threeye11/STM32F4-TouchWeather-OTA-Clock/picture/7.jpg

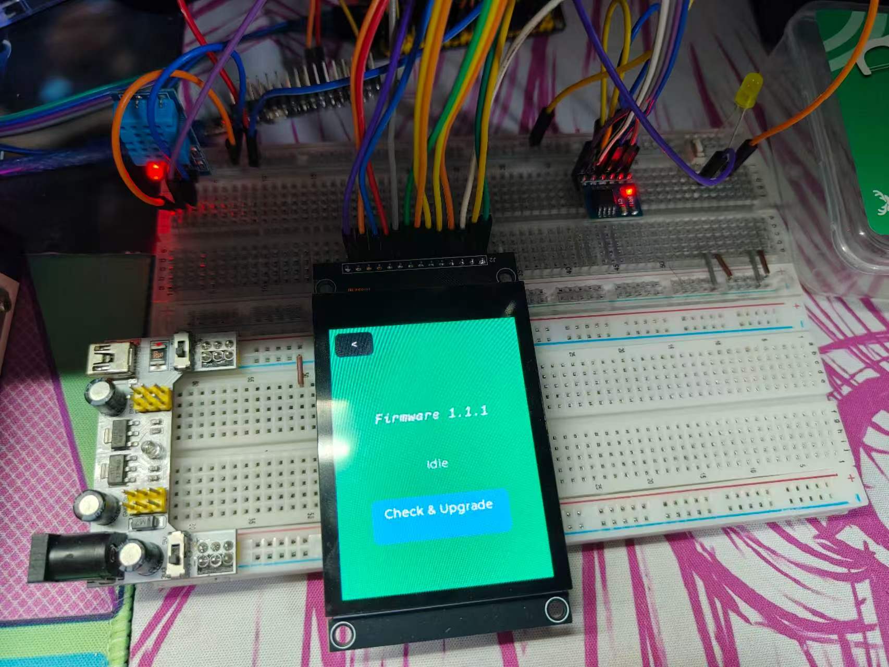
picture/7.jpg
