threeye11/STM32F4-TouchWeather-OTA-Clock/picture/4.jpg

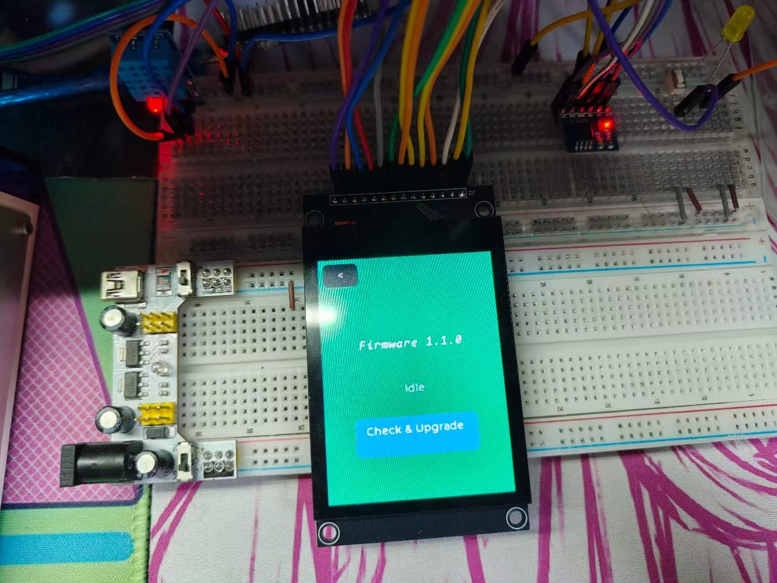
picture/4.jpg
