threeye11/STM32F4-TouchWeather-OTA-Clock/picture/1.jpg

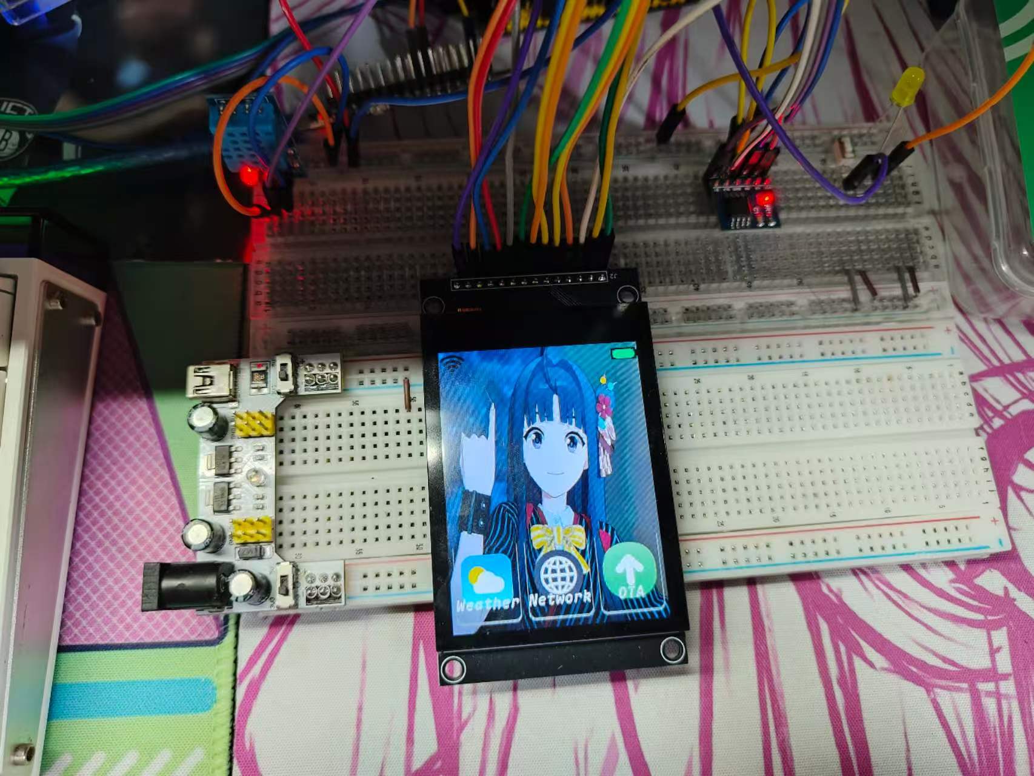
picture/1.jpg
