threeye11/STM32F4-TouchWeather-OTA-Clock/picture/2.jpg

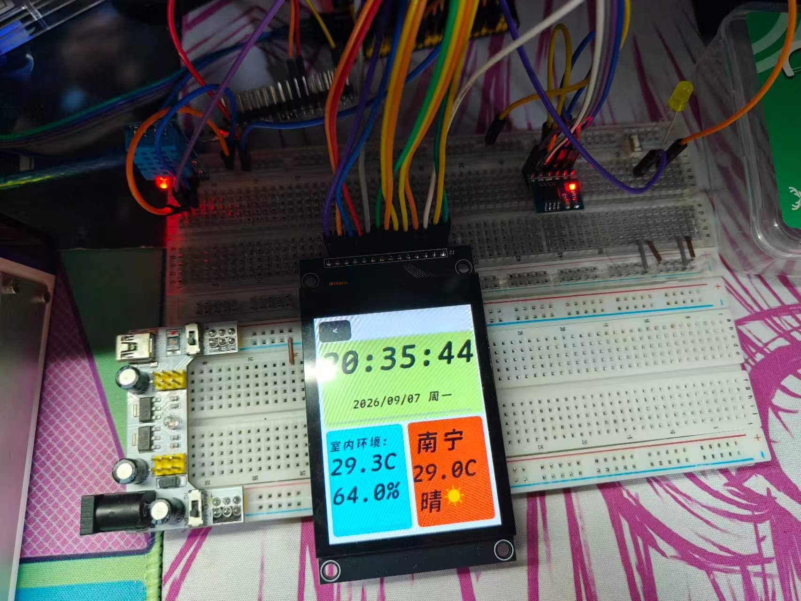
picture/2.jpg
