threeye11/STM32F4-TouchWeather-OTA-Clock/picture/3.jpg

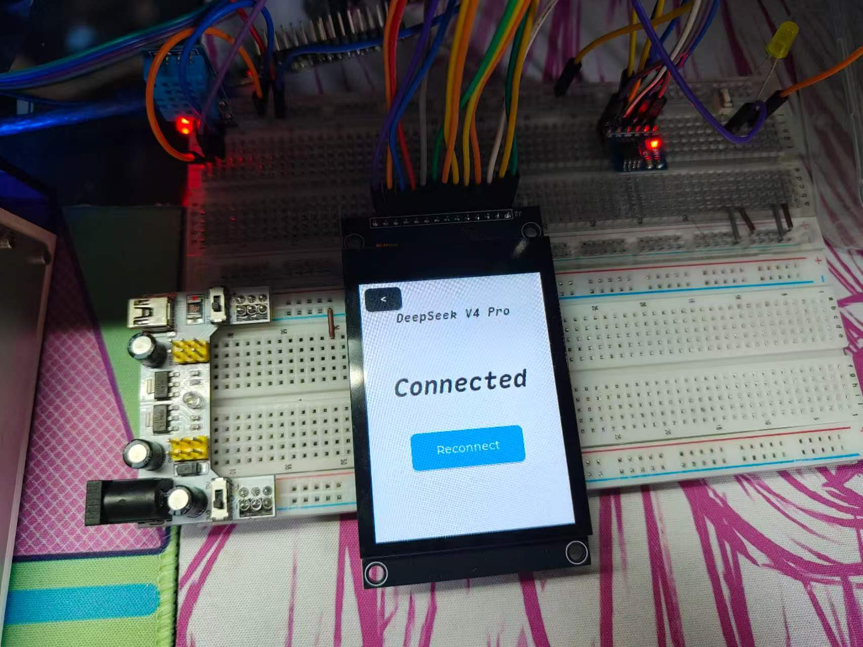
picture/3.jpg
