threeye11/STM32F4-TouchWeather-OTA-Clock/picture/5.jpg

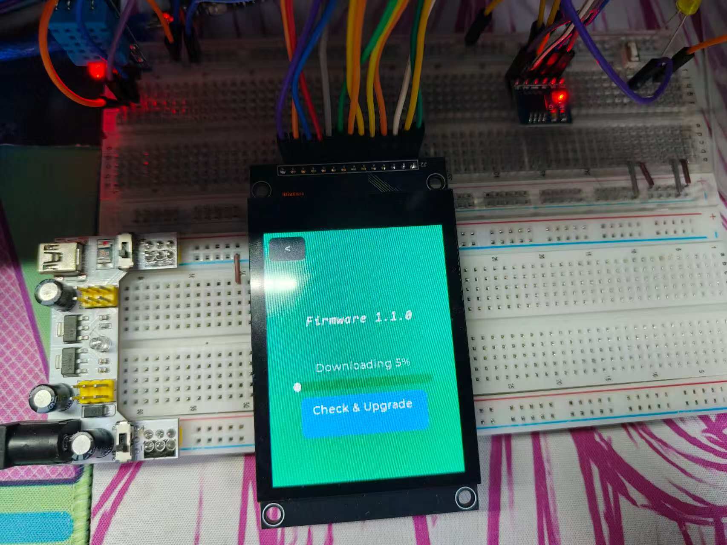
picture/5.jpg
