threeye11/STM32F4-TouchWeather-OTA-Clock/picture/6.jpg

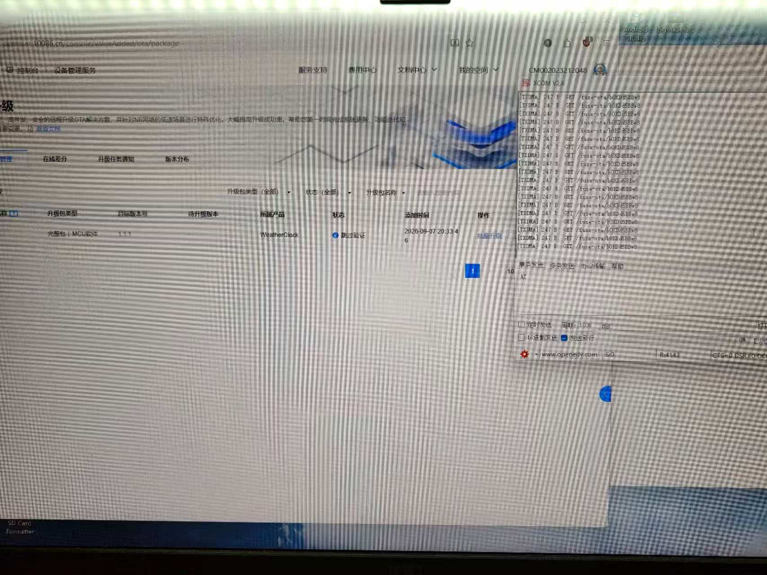
picture/6.jpg
