threeye11/STM32F4-TouchWeather-OTA-Clock/picture/8.jpg

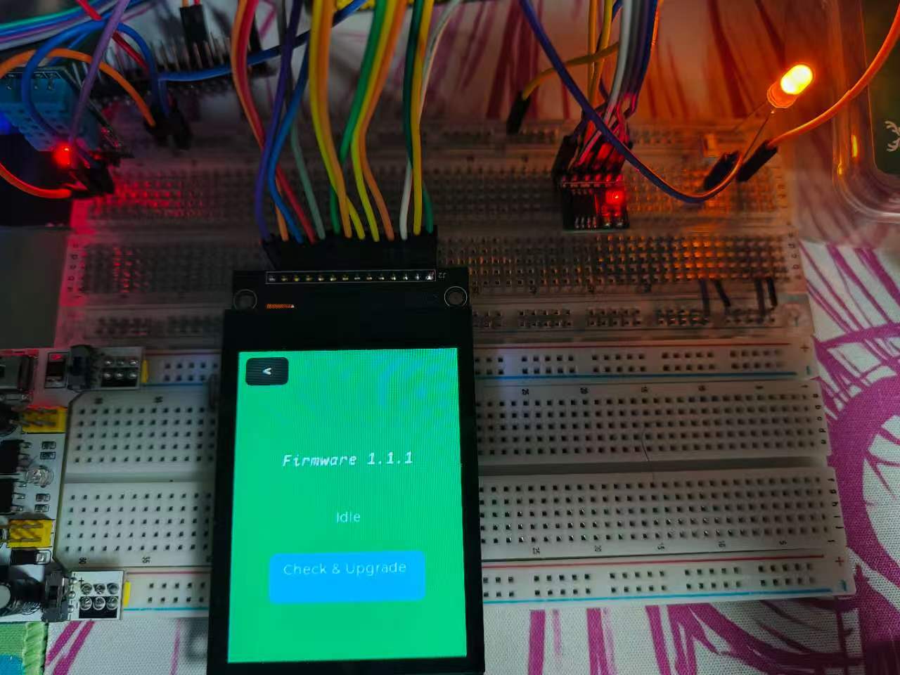
picture/8.jpg
